planta223/f429zi_baqu/doc/AM26LS31CN_Pinout.png

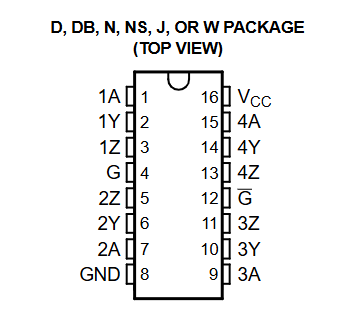
doc/AM26LS31CN_Pinout.png
