planta223/f429zi_baqu/doc/AM26LS32ACN_Pinout.png

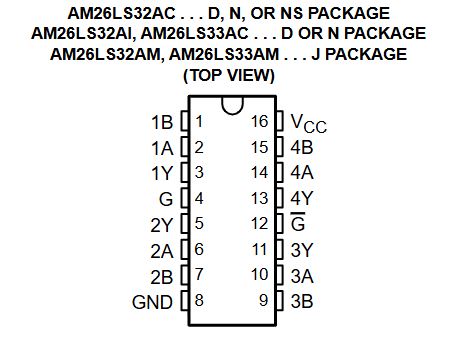
doc/AM26LS32ACN_Pinout.png
