planta223/f429zi_baqu/doc/IRLZ44N_Pinout.png

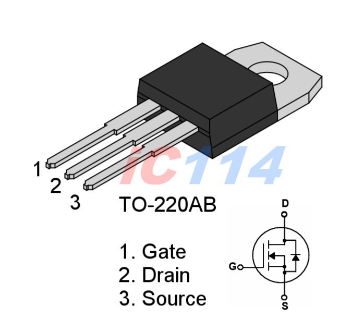
doc/IRLZ44N_Pinout.png
