planta223/f429zi_baqu/doc/NUCLEO_Pinout.png

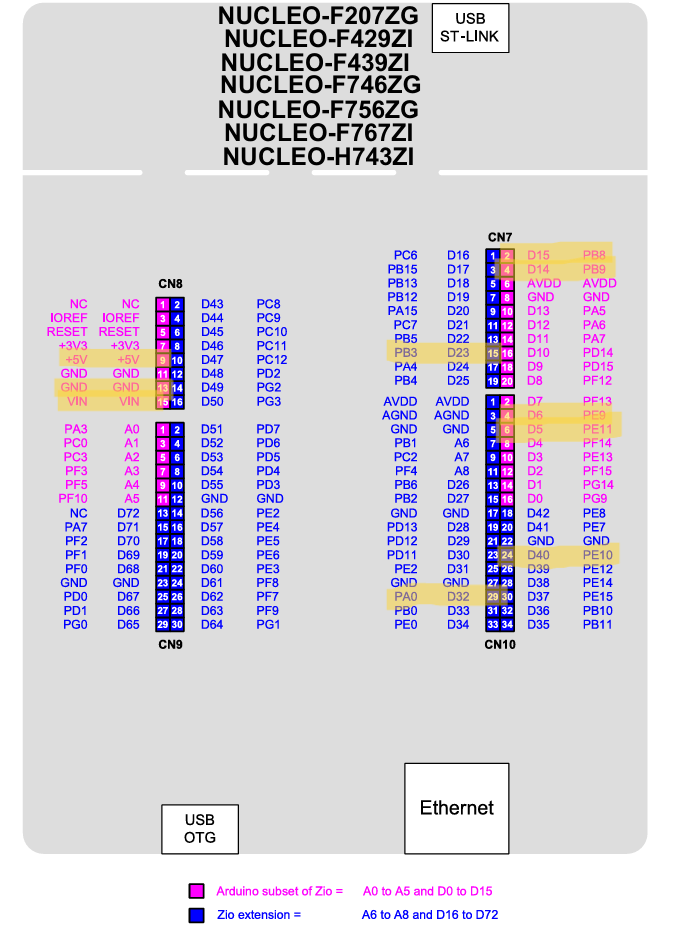
doc/NUCLEO_Pinout.png
