planta223/f429zi_baqu/doc/PUL,DIR결선.png

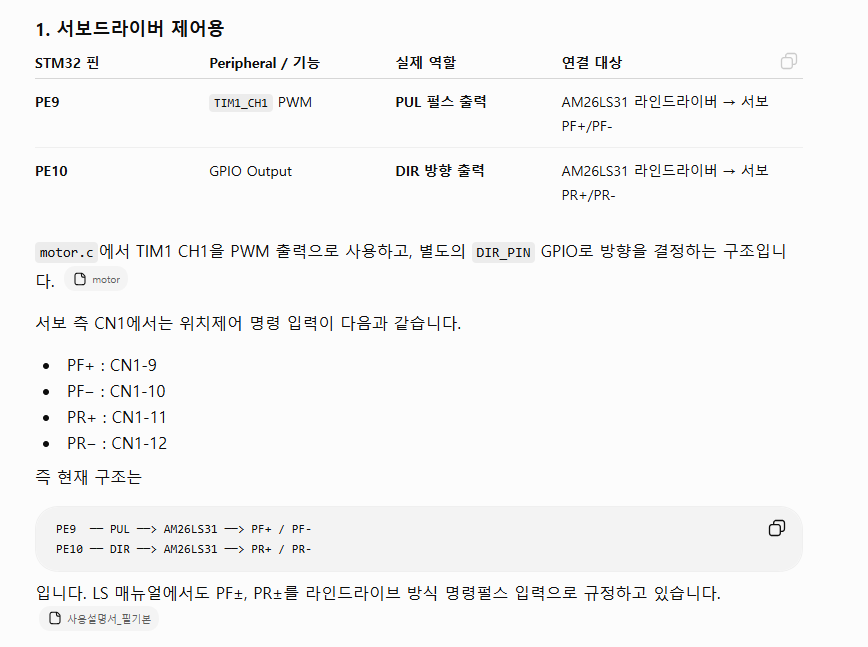
doc/PUL,DIR결선.png
