planta223/f429zi_baqu/doc/ULN2003APG_Pinout.png

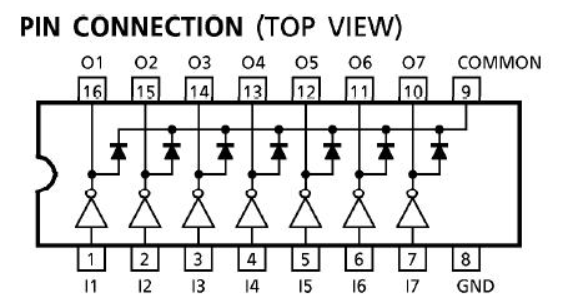
doc/ULN2003APG_Pinout.png
