planta223/f429zi_baqu/doc/엔코더결선.png

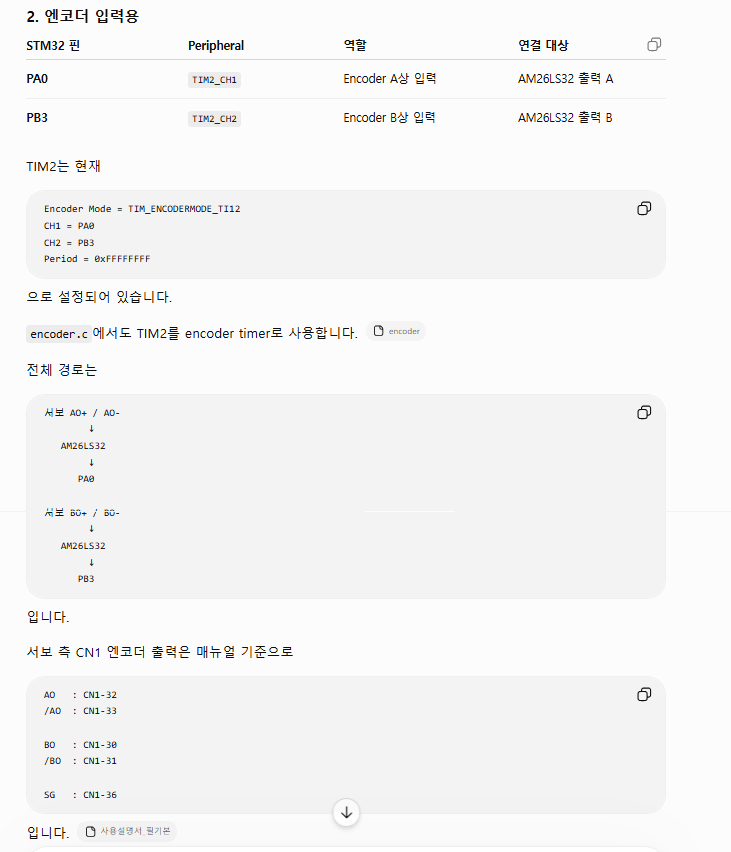
doc/엔코더결선.png
