planta223/f429zi_baqu/Python/logs/UDP_test_v3_20261023_163851_1792741131784318900.csv

pc_time | sent | pc_sent | asms_sent | periodic_sent | one_shot_sent | errors | last_error | last_send_epoch | last_gap_ms | max_gap_ms | timeout_gaps | mode | target_deg | asms_raw | send_age_ms | worker_alive
1792741139.4554524 | 0 | 0 | 0 | 0 | 0 | 0 |  |  |  | 0.0 | 0 | idle | 0.0 | 0 |  | True
1792741140.4565275 | 0 | 0 | 0 | 0 | 0 | 0 |  |  |  | 0.0 | 0 | idle | 0.0 | 0 |  | True
1792741141.4572332 | 0 | 0 | 0 | 0 | 0 | 0 |  |  |  | 0.0 | 0 | idle | 0.0 | 0 |  | True
1792741142.4721963 | 0 | 0 | 0 | 0 | 0 | 0 |  |  |  | 0.0 | 0 | idle | 0.0 | 0 |  | True
1792741143.4808443 | 0 | 0 | 0 | 0 | 0 | 0 |  |  |  | 0.0 | 0 | idle | 0.0 | 0 |  | True
1792741144.4831648 | 0 | 0 | 0 | 0 | 0 | 0 |  |  |  | 0.0 | 0 | idle | 0.0 | 0 |  | True
1792741145.4886057 | 0 | 0 | 0 | 0 | 0 | 0 |  |  |  | 0.0 | 0 | idle | 0.0 | 0 |  | True
1792741146.492763 | 15 | 0 | 15 | 15 | 0 | 0 |  | 1792741146.4844408 | 15.99999999996271 | 31.999999999982265 | 0 | asms | 0.0 | 0 | 15.000000000043201 | True
1792741147.5045893 | 62 | 0 | 62 | 62 | 0 | 0 |  | 1792741147.5045893 | 15.99999999996271 | 47.000000000025466 | 0 | asms | 0.0 | 0 | 0.0 | True
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
