planta223/f429zi_baqu/Python/logs/UDP_test_v3_20261023_165551_1792742151591770600.csv

pc_time | sent | pc_sent | asms_sent | periodic_sent | one_shot_sent | errors | last_error | last_send_epoch | last_gap_ms | max_gap_ms | timeout_gaps | mode | target_deg | asms_raw | send_age_ms | worker_alive
1792742159.4429426 | 0 | 0 | 0 | 0 | 0 | 0 |  |  |  | 0.0 | 0 | idle | 0.0 | 0 |  | True
1792742160.4537563 | 0 | 0 | 0 | 0 | 0 | 0 |  |  |  | 0.0 | 0 | idle | 0.0 | 0 |  | True
1792742161.4586544 | 0 | 0 | 0 | 0 | 0 | 0 |  |  |  | 0.0 | 0 | idle | 0.0 | 0 |  | True
1792742162.4633787 | 0 | 0 | 0 | 0 | 0 | 0 |  |  |  | 0.0 | 0 | idle | 0.0 | 0 |  | True
1792742163.4819005 | 0 | 0 | 0 | 0 | 0 | 0 |  |  |  | 0.0 | 0 | idle | 0.0 | 0 |  | True
1792742164.4982219 | 0 | 0 | 0 | 0 | 0 | 0 |  |  |  | 0.0 | 0 | idle | 0.0 | 0 |  | True
1792742165.5051823 | 0 | 0 | 0 | 0 | 0 | 0 |  |  |  | 0.0 | 0 | idle | 0.0 | 0 |  | True
1792742166.5151305 | 0 | 0 | 0 | 0 | 0 | 0 |  |  |  | 0.0 | 0 | idle | 0.0 | 0 |  | True
1792742167.5205429 | 0 | 0 | 0 | 0 | 0 | 0 |  |  |  | 0.0 | 0 | idle | 0.0 | 0 |  | True
1792742168.5325725 | 0 | 0 | 0 | 0 | 0 | 0 |  |  |  | 0.0 | 0 | idle | 0.0 | 0 |  | True
1792742169.5460525 | 0 | 0 | 0 | 0 | 0 | 0 |  |  |  | 0.0 | 0 | idle | 0.0 | 0 |  | True
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
