planta223/f429zi_baqu/Python/logs/UDP_test_v3_20261023_165625_1792742185914271900.csv

pc_time | sent | pc_sent | asms_sent | periodic_sent | one_shot_sent | errors | last_error | last_send_epoch | last_gap_ms | max_gap_ms | timeout_gaps | mode | target_deg | asms_raw | send_age_ms | worker_alive
1792742193.9545064 | 0 | 0 | 0 | 0 | 0 | 0 |  |  |  | 0.0 | 0 | idle | 0.0 | 0 |  | True
1792742194.9697037 | 0 | 0 | 0 | 0 | 0 | 0 |  |  |  | 0.0 | 0 | idle | 0.0 | 0 |  | True
