planta223/f429zi_baqu/Python/logs/UDP_test_v3_20261023_165839_1792742319668896600.csv

pc_time | sent | pc_sent | asms_sent | periodic_sent | one_shot_sent | errors | last_error | last_send_epoch | last_gap_ms | max_gap_ms | timeout_gaps | mode | target_deg | asms_raw | send_age_ms | worker_alive
1792742327.5020764 | 0 | 0 | 0 | 0 | 0 | 0 |  |  |  | 0.0 | 0 | idle | 0.0 | 0 |  | True
1792742328.5107195 | 0 | 0 | 0 | 0 | 0 | 0 |  |  |  | 0.0 | 0 | idle | 0.0 | 0 |  | True
1792742329.5157995 | 0 | 0 | 0 | 0 | 0 | 0 |  |  |  | 0.0 | 0 | idle | 0.0 | 0 |  | True
1792742330.5344827 | 0 | 0 | 0 | 0 | 0 | 0 |  |  |  | 0.0 | 0 | idle | 0.0 | 0 |  | True
1792742331.5483043 | 0 | 0 | 0 | 0 | 0 | 0 |  |  |  | 0.0 | 0 | idle | 0.0 | 0 |  | True
1792742332.5606582 | 0 | 0 | 0 | 0 | 0 | 0 |  |  |  | 0.0 | 0 | idle | 0.0 | 0 |  | True
1792742333.5767136 | 0 | 0 | 0 | 0 | 0 | 0 |  |  |  | 0.0 | 0 | idle | 0.0 | 0 |  | True
1792742334.5837727 | 0 | 0 | 0 | 0 | 0 | 0 |  |  |  | 0.0 | 0 | idle | 0.0 | 0 |  | True
1792742335.585166 | 0 | 0 | 0 | 0 | 0 | 0 |  |  |  | 0.0 | 0 | idle | 0.0 | 0 |  | True
1792742336.605702 | 0 | 0 | 0 | 0 | 0 | 0 |  |  |  | 0.0 | 0 | idle | 0.0 | 0 |  | True
1792742337.6083431 | 0 | 0 | 0 | 0 | 0 | 0 |  |  |  | 0.0 | 0 | idle | 0.0 | 0 |  | True
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
