planta223/f429zi_baqu/Python/logs/UDP_test_v3_20261023_170001_1792742401261131200.csv

pc_time | sent | pc_sent | asms_sent | periodic_sent | one_shot_sent | errors | last_error | last_send_epoch | last_gap_ms | max_gap_ms | timeout_gaps | mode | target_deg | asms_raw | send_age_ms | worker_alive
1792742408.92912 | 0 | 0 | 0 | 0 | 0 | 0 |  |  |  | 0.0 | 0 | idle | 0.0 | 0 |  | True
1792742409.9402528 | 0 | 0 | 0 | 0 | 0 | 0 |  |  |  | 0.0 | 0 | idle | 0.0 | 0 |  | True
1792742410.9558902 | 0 | 0 | 0 | 0 | 0 | 0 |  |  |  | 0.0 | 0 | idle | 0.0 | 0 |  | True
1792742411.969242 | 0 | 0 | 0 | 0 | 0 | 0 |  |  |  | 0.0 | 0 | idle | 0.0 | 0 |  | True
1792742412.9735804 | 0 | 0 | 0 | 0 | 0 | 0 |  |  |  | 0.0 | 0 | idle | 0.0 | 0 |  | True
1792742413.9887266 | 0 | 0 | 0 | 0 | 0 | 0 |  |  |  | 0.0 | 0 | idle | 0.0 | 0 |  | True
