planta223/f429zi_baqu/(list of files, drawings)

Other design files:
PCB/V1.0/ProPrj_baqu_PCB_kyubeom_2026-08-27.epro
