planta223/f429zi_baqu/Core/Src/main.c

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
/* Includes ------------------------------------------------------------------*/
#include "main.h"
#include "iwdg.h"
#include "tim.h"
#include "usart.h"
#include "gpio.h"

/* USER CODE BEGIN Includes */
#include "can.h"
#include "lwip.h"

#include "config.h"
#include "encoder.h"
#include "motor.h"
#include "control.h"
#include "svon.h"
#include "comm_can.h"
#include "comm_ethernet.h"
#include "comm_manager.h"
#include "led.h"

/* USER CODE END Includes */


void SystemClock_Config(void);
/**
  * @brief  The application entry point.
  * @retval int
  */
int main(void)
{

  /* MCU Configuration--------------------------------------------------------*/

  /* Reset of all peripherals, Initializes the Flash interface and the Systick. */
  HAL_Init();

  /* Configure the system clock */
  SystemClock_Config();

  /* Initialize all configured peripherals */
  MX_GPIO_Init();
  MX_USART3_UART_Init();
  MX_TIM1_Init();
  MX_TIM2_Init();
  MX_IWDG_Init();
  /* USER CODE BEGIN 2 */

  #if ((COMM_MODE == COMM_MODE_ETHERNET_ONLY) || (COMM_MODE == COMM_MODE_BOTH))
      MX_LWIP_Init();
  #endif
  #if ((COMM_MODE == COMM_MODE_CAN_ONLY) || (COMM_MODE == COMM_MODE_BOTH))
      MX_CAN1_Init();
  #endif

  LED_Init();
  Encoder_Init();
  Motor_Init();
  Control_Init();
  SVON_Init();

  Encoder_Reset();
  Control_Reset();
  Control_SetTargetSteeringDeg(0.0f);

  Control_Disable();
  SVON_Disable();

  CommManager_Init();

  /* USER CODE END 2 */

  /* Infinite loop */
  /* USER CODE BEGIN WHILE */

  uint32_t last_control_tick_ms = HAL_GetTick();

  while (1)
  {
      #if ((COMM_MODE == COMM_MODE_ETHERNET_ONLY) || (COMM_MODE == COMM_MODE_BOTH))
	  	  MX_LWIP_Process();
	  #endif

      /*
      * 모든 통신 / mode / timeout / status 처리
      */
      CommManager_Update();


      /*
      * control loop
      */
      uint32_t now_ms = HAL_GetTick();

      if ((uint32_t)(
              now_ms -
              last_control_tick_ms)
          >= CONTROL_PERIOD_MS) {

          last_control_tick_ms +=
              CONTROL_PERIOD_MS;

          Encoder_Update();
          Control_Update();
      }

	    HAL_IWDG_Refresh(&hiwdg);
    /* USER CODE END WHILE */

    /* USER CODE BEGIN 3 */
  }
  /* USER CODE END 3 */
}

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
