planta223/f429zi_baqu/Core/Inc/led.h

/*
 * led.h
 *
 *  Created on: Sep 19, 2026
 *      Author: kyubeom
 */

#ifndef INC_LED_H_
#define INC_LED_H_

void LED_Init(void);

void LED_GREEN_ON(void);
void LED_GREEN_OFF(void);

void LED_BLUE_ON(void);
void LED_BLUE_OFF(void);

void LED_RED_ON(void);
void LED_RED_OFF(void);

#endif /* INC_LED_H_ */
