planta223/f429zi_baqu/(commit log)

2026-05-15 ioc 설정 및 code generate
2026-05-15 github 연동을 위한 .gitignore 및 README.md 생성
2026-05-22 encoder/motor/control 모듈 생성 및 작성. (모터 돌아감. 검증 및 튜닝 필요)
2026-05-22 encoder 및 CW/CCW 방향 상수 옳게 바꿈.
2026-05-23 코드 정리함. 튜닝 준비 완료
2026-05-23 P제어만. P=500, FREQ_MAX=600000, 임시값(volatile) 변수 모두 제거
2026-05-23 Gateway IP 삭제, ethernet.c/h 생성 및 작성함
2026-05-23 UDT_test.py 생성(정상 동작은 안함)
2026-05-23 UDP 코드 동작하는거로 수정함
2026-05-23 조향값 관련 파라미터 1개 수정
    [config.h]
2026-05-23 README 최신화
2026-05-24 asms 폴라리티 수정, asms uint16->int16 변경
    [config.h]
2026-05-24 TIM2엔코더모드 필터계수 4->2, README 최신화
2026-06-27 코드 변경 중간 저장
2026-06-27 config에서 pulse 24000->12000 수정함. (main branch 에서도 수정 필요)
    [config.h]
2026-06-27 변경사항 저장... 근데 오차쌓이는거 해결 못함
2026-06-28 +-30도 조향설정
2026-06-28 기어비 파라미터 최종 수정. 약 +-30도
    [config.h]
2026-07-05 엔코더 해결, 펄스명령 작업시작
2026-07-05 하드웨어 수정(라인드라이버,라인리시버 만 사용) 후 config 수정
    [config.h]
2026-08-22 document 추가
2026-08-22 svon 로직 추가
2026-08-22 svon 핀 변경 PE11->PF14
2026-08-22 svon 핀 복귀 변경 PE14->PE11
2026-08-22 통신 타임아웃 해결
2026-08-22 main.c 루프 로직 깔끔히 수정
    [config.h, main.c]
2026-08-22 README 수정
2026-08-22 pc 단독 테스트 로직 추가
2026-08-23 PC, ASMS 아이피 구분하도록 설정
2026-08-27 PCB 파일 추가
    [ProPrj_baqu_PCB_kyubeom_2026-08-27.epro]
2026-08-27 can ioc 설정 및 통신 관련 모듈화 (manager, ethernet, can)
2026-08-27 삭제된 사항 반영
2026-08-27 통신 코드 리팩토링 준비 및 config 수정
    [comm_ethernet.c, comm_ethernet.h, config.h, main.c]
2026-08-29 config 수정
2026-08-29 통신코드 리팩토링 v1.0
2026-08-29 통신코드 리팩토링 v2.0
2026-08-29 통신코드 리팩토링 v2.1
2026-08-29 통신코드 리팩토링 v2.2
2026-08-29 통신 테스트 python 작성
2026-09-04 CandoCAN_test.py 작성
2026-09-04 cando 수정 등
2026-09-08 뭐 language setting 변경
2026-09-19 PLL source를 HSE -> HSI 변경
2026-09-19 제어주기 혼재를 막기 위해 LWIP / CAN 프로세스 조건 추가
2026-09-19 CAN ESTOP 정책 사소 수정
    [comm_can.c]
2026-09-19 LED 추가, ioc에서 do not generate LWIP/CAN 설정
2026-09-19 UDP_test_v2 수정 (led는 동작, svon은 미동작)
2026-09-22 HSI CAN 통신적체 -> HSE CAN 정상동작 확인
2026-09-22 다시 HSI로 복귀했으며, CAN1 SJW를 1->2 변경
2026-09-22 can test 결과 HSICalibrationValue = 10U 최적 확인. (다른 온도 확인 필요하며 ethernet 테스트도 필요함. 또한 cubeMX가 덮어쓰지 않도록 코드 수정 필요)
2026-10-19 cantest 관련
2026-10-19 TX(status) config 정의
2026-10-19 encoder.h/c 엔코더측정시각 추가
2026-10-19 ethernet.h/c TX패킷 정의 및 함수 추가
2026-10-19 config에 송신주기 추가
2026-10-19 comm_manager.c TX 관련 설정
2026-10-19 ethernetif.c 송신실패 로직 변경
2026-10-19 UDP_status_rx.py 구현 및 모든부분 정상 확인
2026-10-19 기하학, 엔코더 기반 조향각 config 반영
2026-10-19 homing.c/h 생성 및 config 추가
2026-10-19 homing.c/h 작성
2026-10-19 encoder.c 에서 homing 관련 로직 추가
2026-10-19 main.c 에서 homing 관련 로직 추가
2026-10-19 comm_manager.c 에서 homing 관련 로직 추가
2026-10-19 main.c 루프에서 homing 관련 로직 추가
2026-10-19 버그 수정
2026-10-19 도달 margin 0.25->0.10 수정 및 homing 테스트 완료
2026-10-19 PC, ASMS 둘다 homing 가능하게 수정
2026-10-19 UDP_test_v3.py 작성 (검증 안함)
2026-10-20 PC misc 패킷 무시하도록 변경 (기존:ESTOP -> 변경:Brake)
2026-10-21 실제 조향측정각 반영하여 config 수정
2026-10-21 homing 관련 ramp로 동작하게 수정
2026-10-21 PC UDP 수신부 int32->float32 변경
2026-10-21 UDP_teest_v4.py 작성 (float32 반영)
2026-10-23 테스트로그 저장 (쓰레기)
2026-10-23 실측기반 호밍 테스트
2026-10-23 조금더 오른쪽으로 해야
2026-10-23 원점 잠정 확정
